Nam2862003/DMMS/(commit log)

2026-06-02 calibrated plot
2026-06-03 Removal of 180 calibration
2026-06-03 Configurations for 3 fingers
    Pins definition for 3 fingers
    GUI layout update
